jeminanda/Battery_Gas_Monitor/(commit log)

2026-10-06 .gitignore 파일 업데이트 및 불필요한 설정 파일 삭제
2026-10-07 cubemx: TIM3 원펄스(PA6) 및 PB10/PB4/PB5 GPIO 설정
2026-10-07 INA219 전류 측정
2026-10-07 TP4056 충전 상태
2026-10-07 충전 차단 MOSFET(PB10) 제어 및 경보 시 차단
2026-10-07 전류 적분 SOC 추정 (완충 리셋, 휴지 시 OCV 보정)
2026-10-07 내부 저항(DCIR) 측정 (TIM3 원펄스 부하, 충전 차단 인터록, $DCIR 패킷)
2026-10-07 $BAT 패킷에 전류/충전/SOC 필드 추가
2026-10-08 ntc 추가
2026-10-08 bme680추가,bosch sensor 드라이버 추가
2026-10-08 data필드 업데이트
2026-10-08 bme680+ntcb3950추가
2026-10-08 가스판단값mq->bme로 변경
2026-10-08 데이터 필드 업데이트
2026-10-08 CubeMx업데이트
2026-10-08 BME680,NTCB3950추가,MQ,DHT해제
2026-10-08 주석 추가
2026-10-08 모듈별 주석 추가
2026-10-10 dcir 추가, tp4056 제외, 임계값 변경 명령 추가
2026-10-13 warmup5분으로 수정
2026-10-13 README.md추가
